denderden5621/PocketPal/images/05_baski_yonleri.png

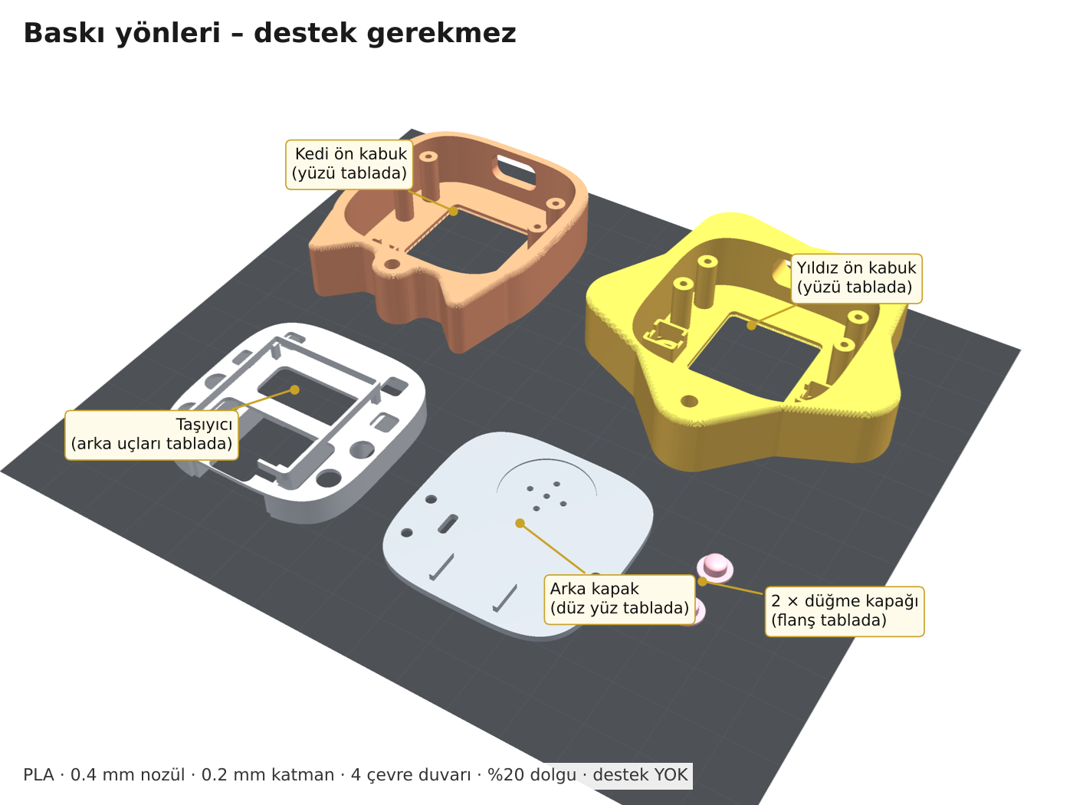
images/05_baski_yonleri.png
