denderden5621/PocketPal/images/06_kontroller.png

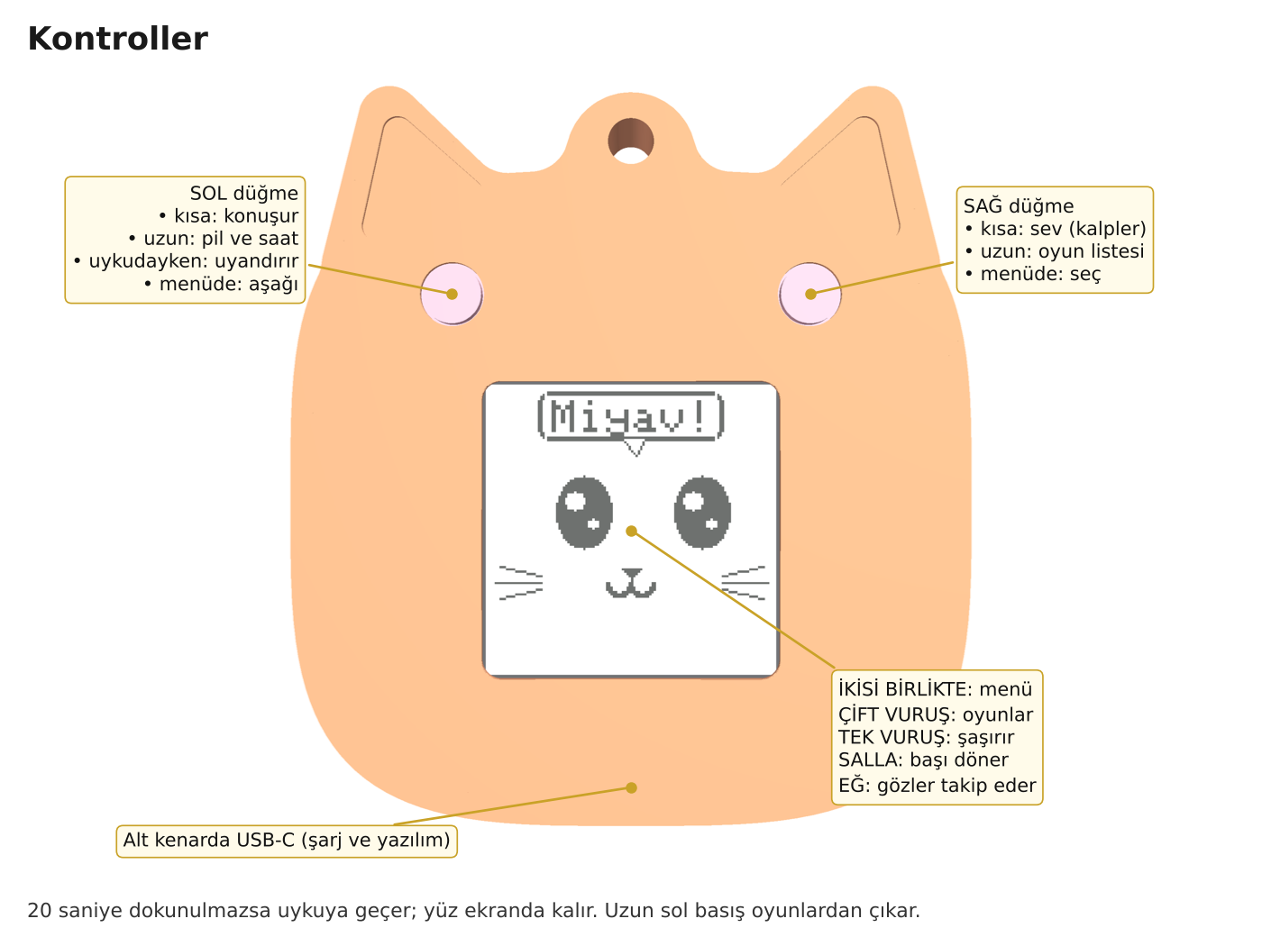
images/06_kontroller.png
