denderden5621/PocketPal/images/21_fpc_adaptor.png

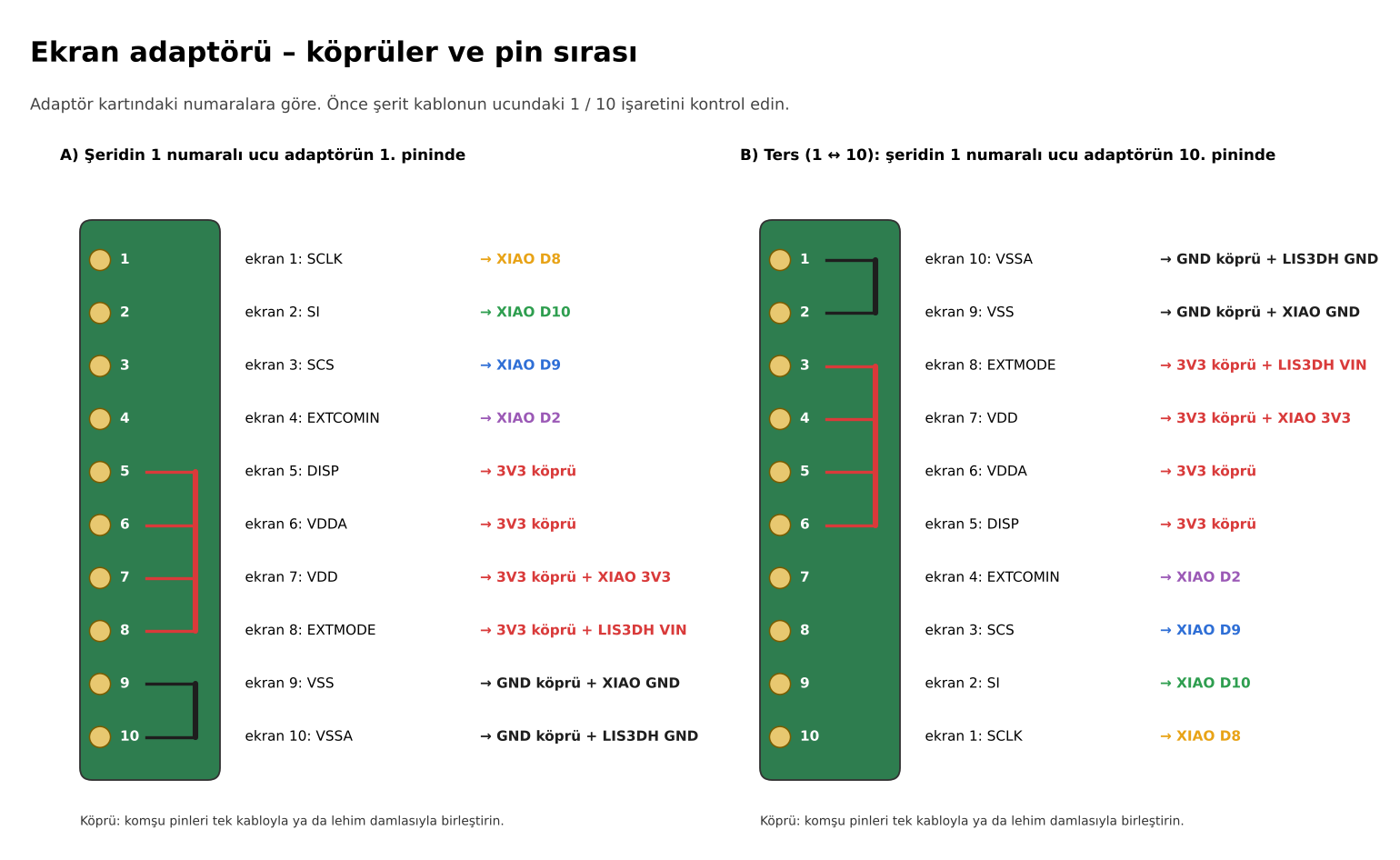
images/21_fpc_adaptor.png
