denderden5621/PocketPal/images/22_lis3dh_diyot.png

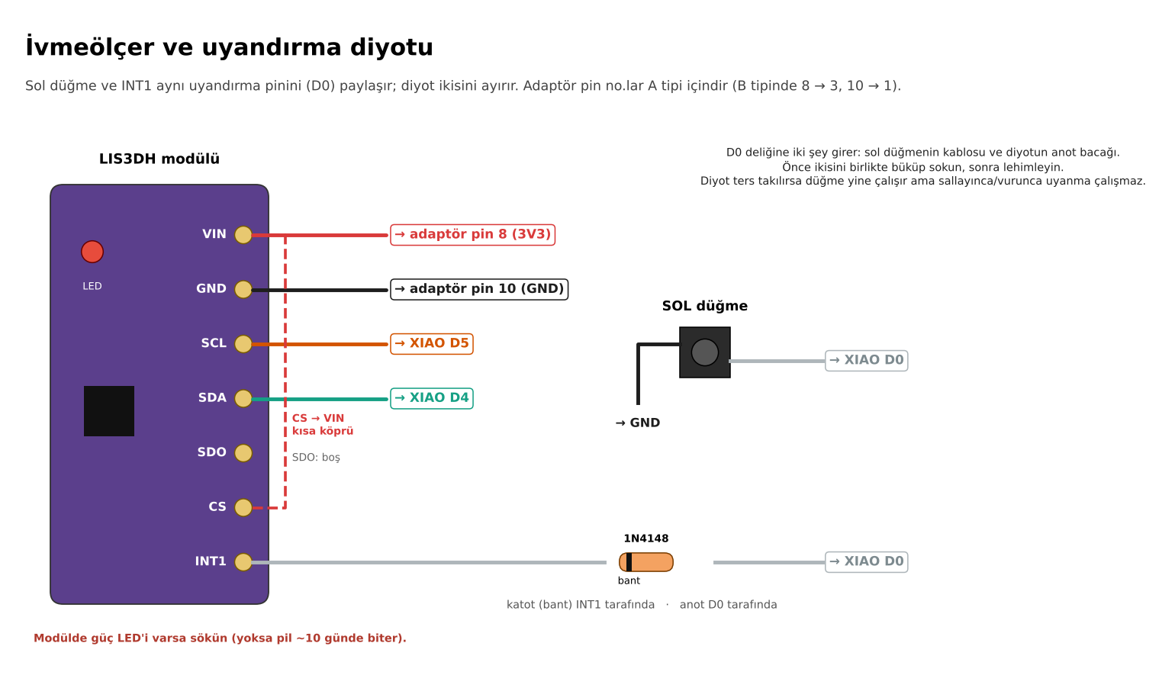
images/22_lis3dh_diyot.png
