denderden5621/PocketPal/images/23_guc_bolucu.png

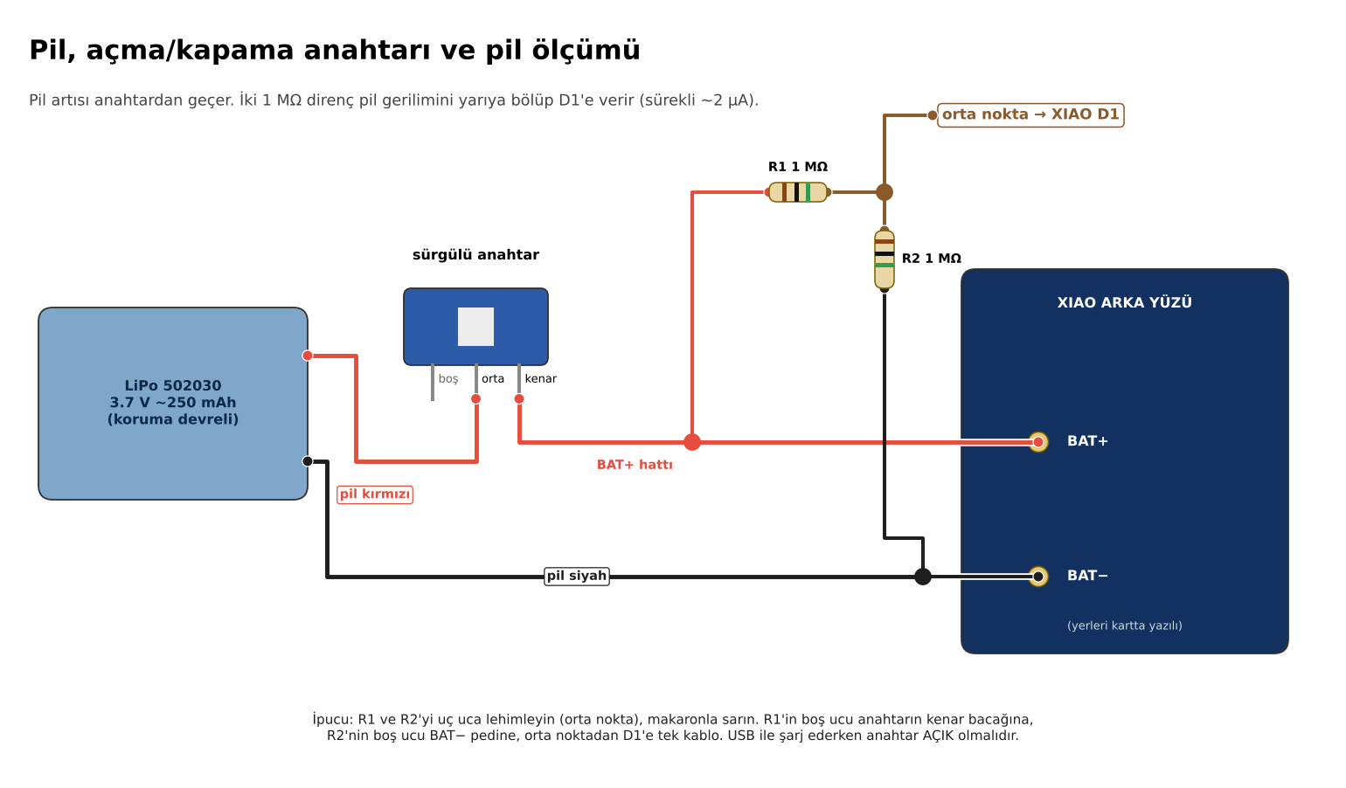
images/23_guc_bolucu.png
