denderden5621/PocketPal/images/screens/oyun_zipla_yildiz.png

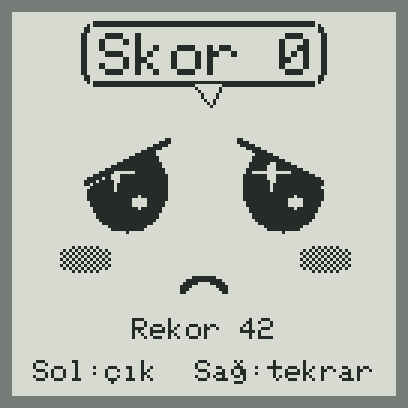
images/screens/oyun_zipla_yildiz.png
