denderden5621/PocketPal/images/screens/yildiz_bubble.png

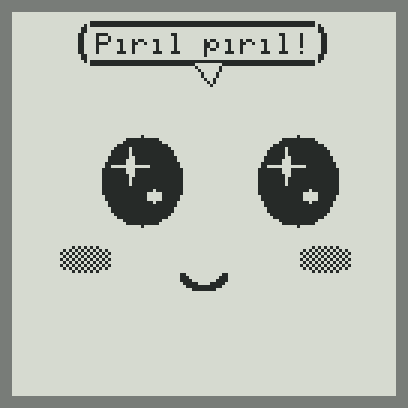
images/screens/yildiz_bubble.png
