denderden5621/PocketPal/images/screens/yildiz_sleepy.png

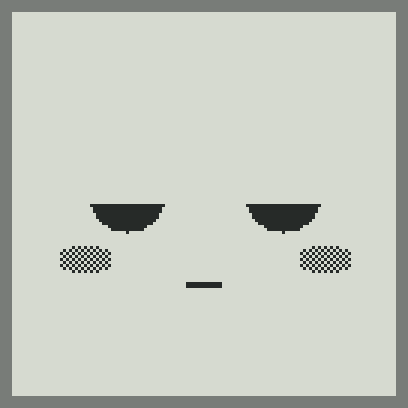
images/screens/yildiz_sleepy.png
