denderden5621/PocketPal/stl/kedi_on_kabuk.stl

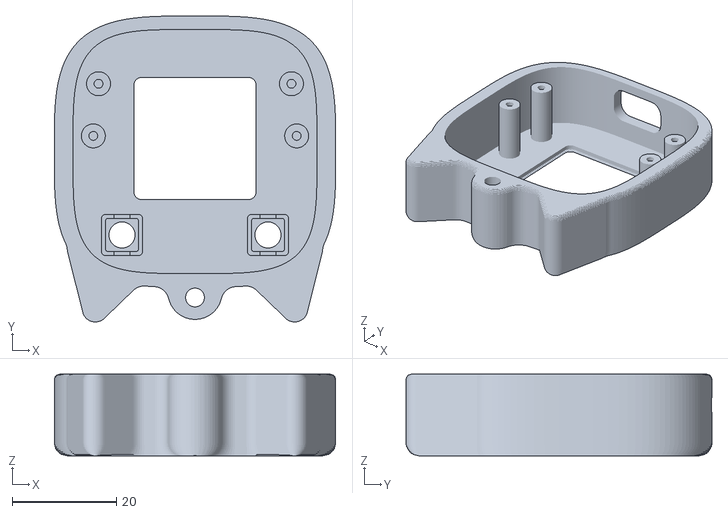
[picture p47: CAD file, 2026-10-17]
stl/kedi_on_kabuk.stl
54.0 x 58.7 x 15.6
