denderden5621/PocketPal/stl/dugme_kapagi.stl

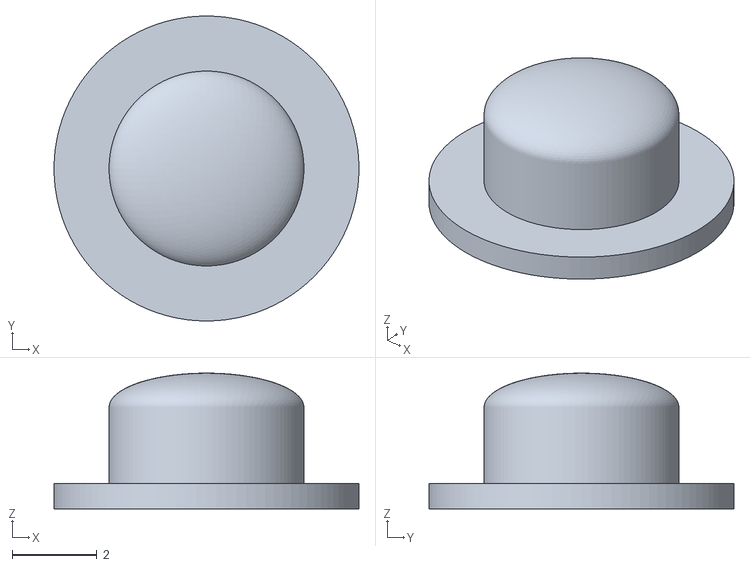
[picture p48: CAD file, 2026-10-17]
stl/dugme_kapagi.stl
7.20 x 7.20 x 3.20
