denderden5621/PocketPal/stl/arka_kapak.stl

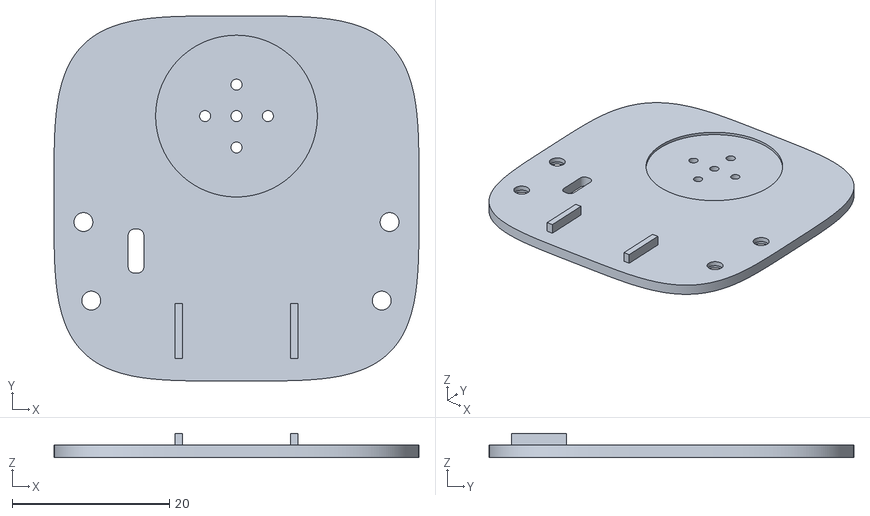
[picture p49: CAD file, 2026-10-17]
stl/arka_kapak.stl
46.5 x 46.5 x 3.10
