denderden5621/PocketPal/stl/yildiz_on_kabuk.stl

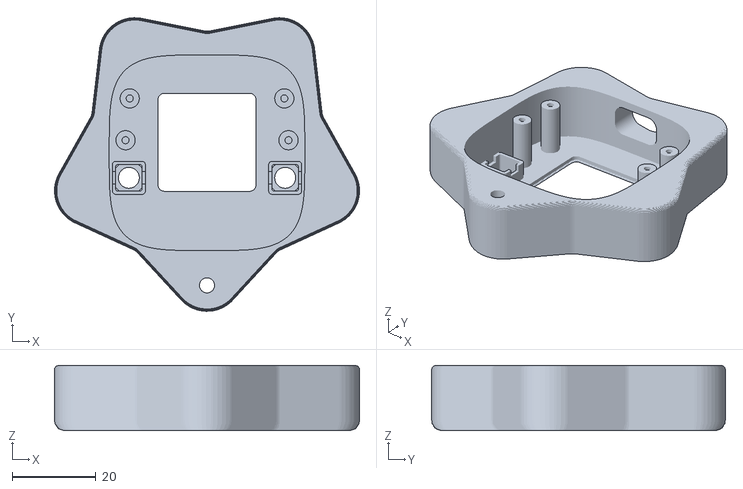
[picture p50: CAD file, 2026-10-17]
stl/yildiz_on_kabuk.stl
73.0 x 70.3 x 15.6
