denderden5621/PocketPal/stl/tasiyici.stl

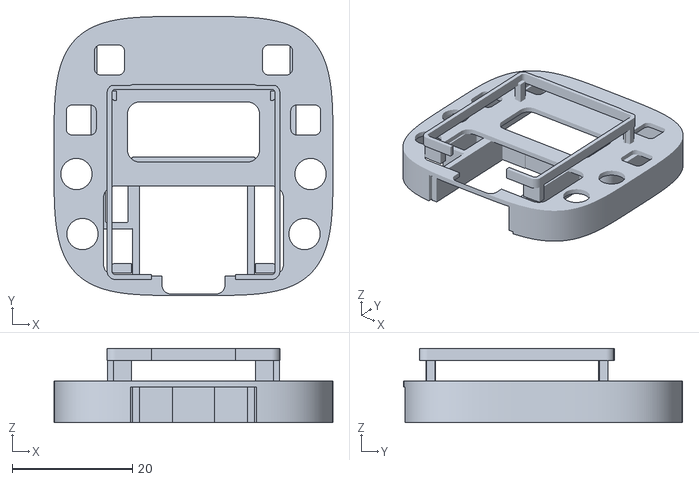
[picture p51: CAD file, 2026-10-17]
stl/tasiyici.stl
46.5 x 46.5 x 12.4
