denderden5621/PocketPal/images/10_montaj_on_katman.png

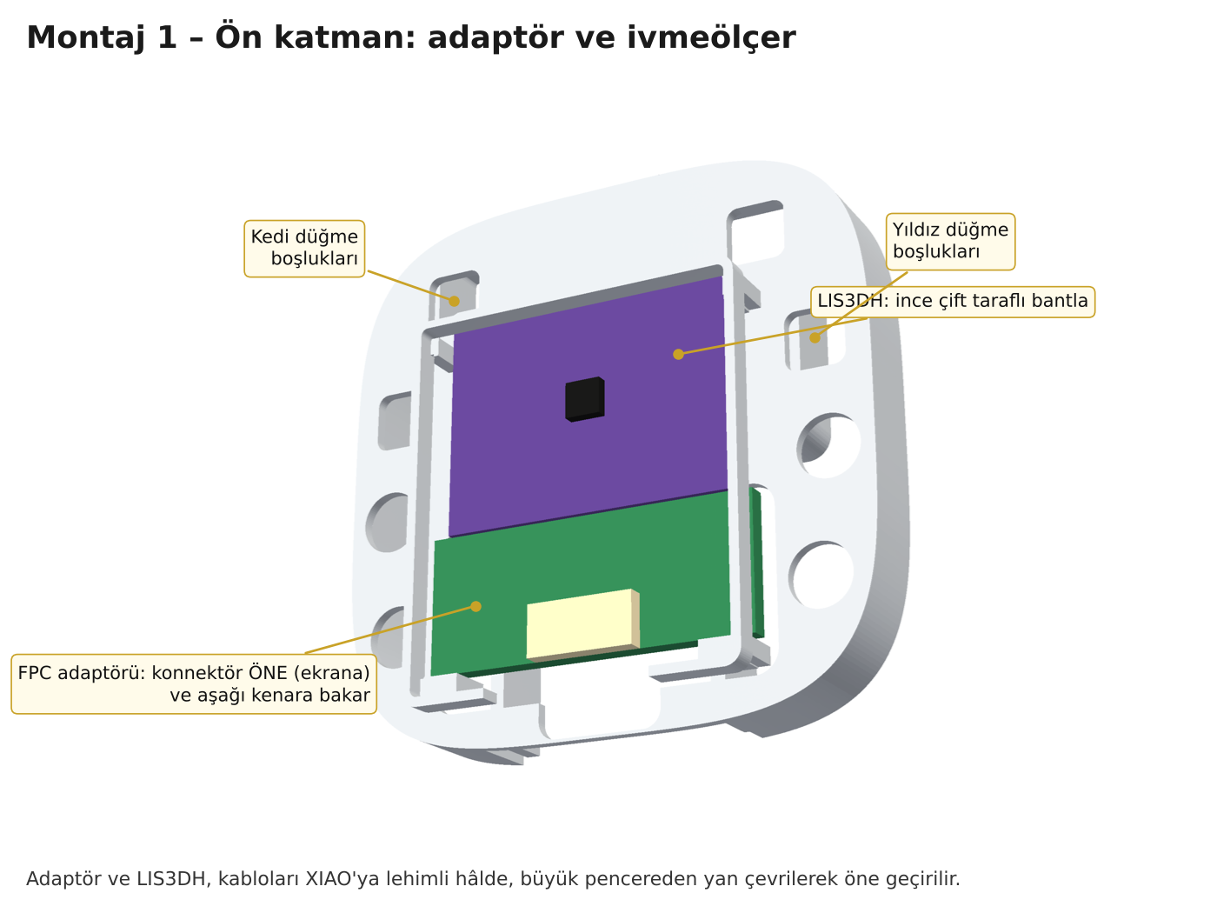
images/10_montaj_on_katman.png
