denderden5621/PocketPal/images/11_montaj_ekran.png

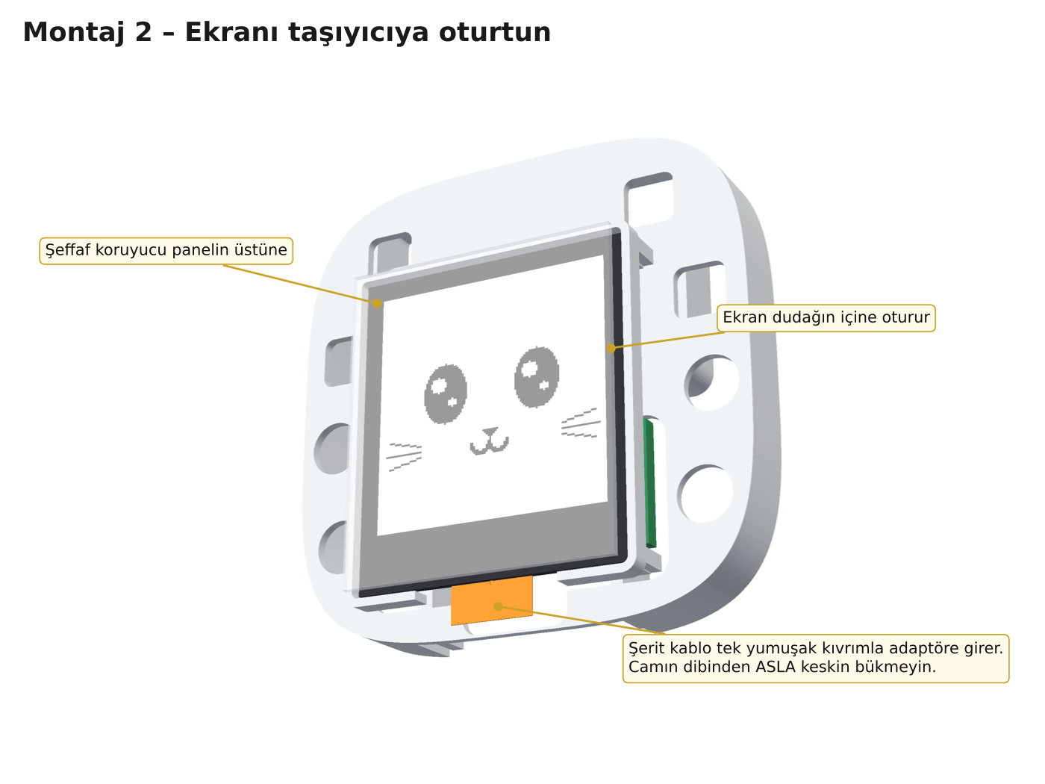
images/11_montaj_ekran.png
