denderden5621/PocketPal/images/12_montaj_arka_katman.png

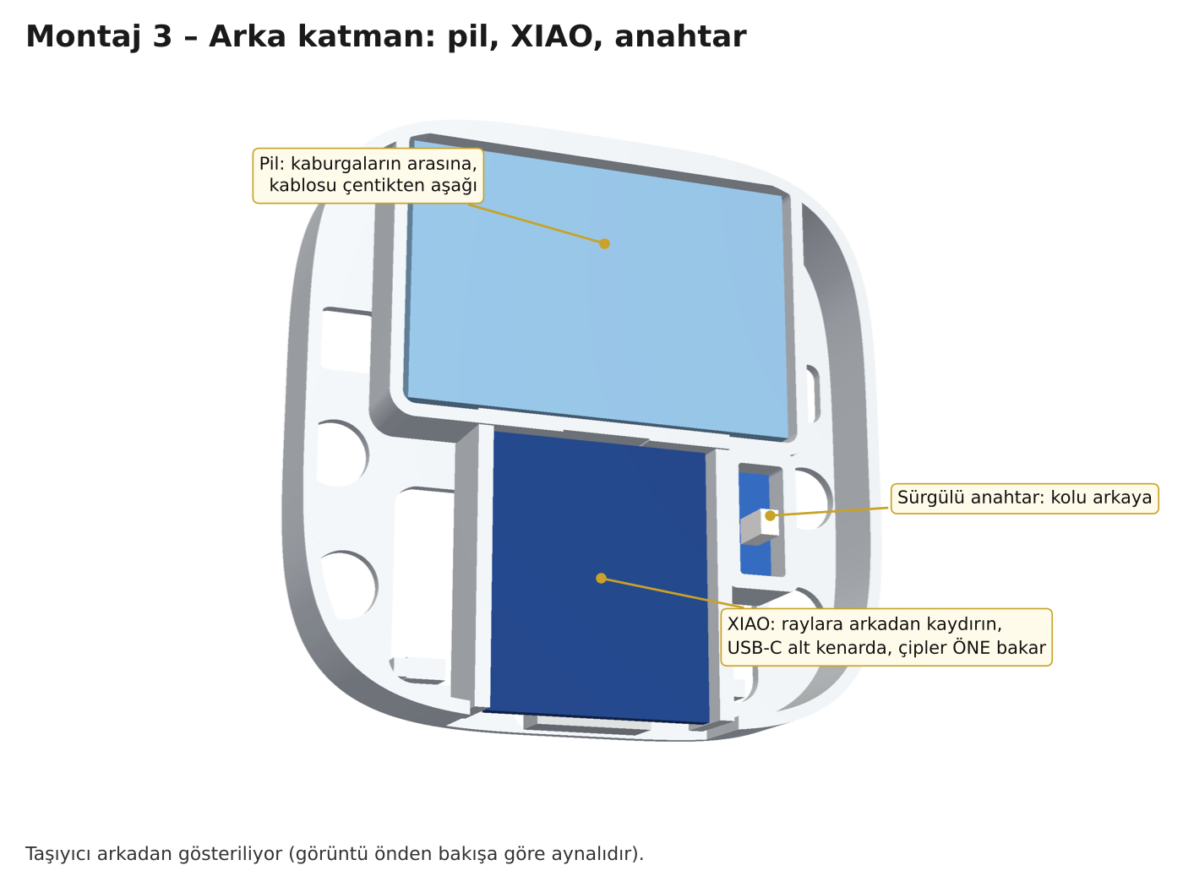
images/12_montaj_arka_katman.png
