denderden5621/PocketPal/images/13_montaj_piezo.png

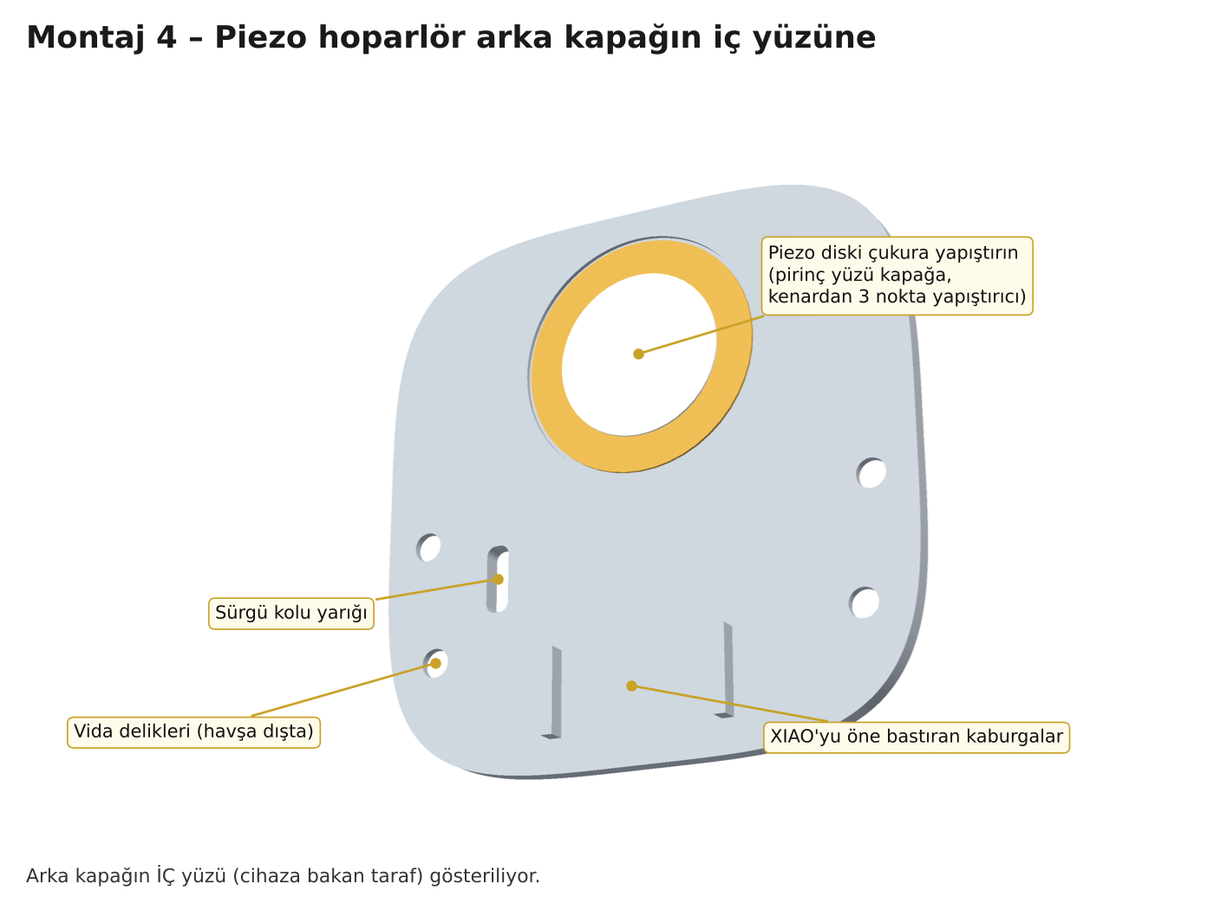
images/13_montaj_piezo.png
