denderden5621/PocketPal/images/14_montaj_dugmeler_kedi.png

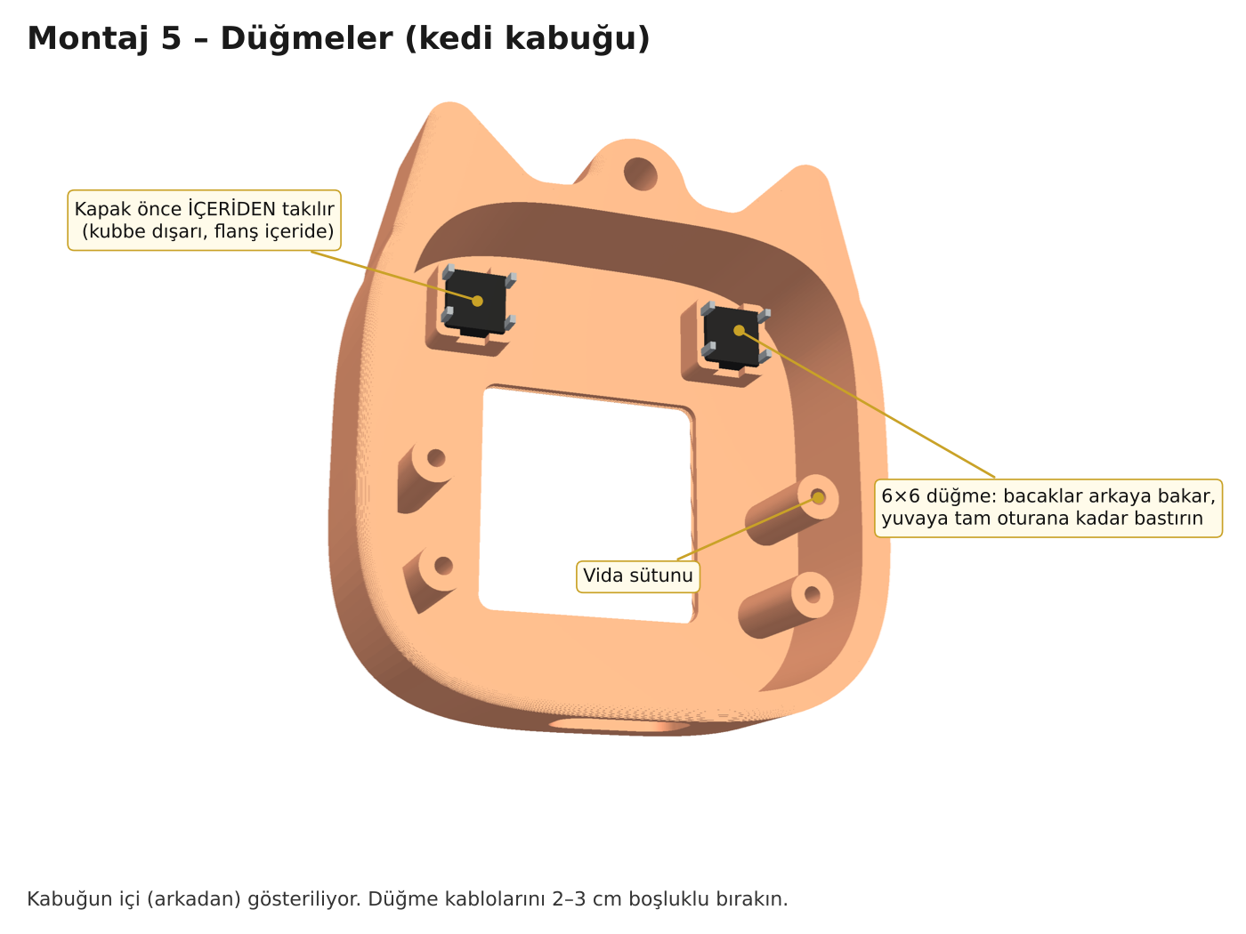
images/14_montaj_dugmeler_kedi.png
