denderden5621/PocketPal/images/15_montaj_dugmeler_yildiz.png

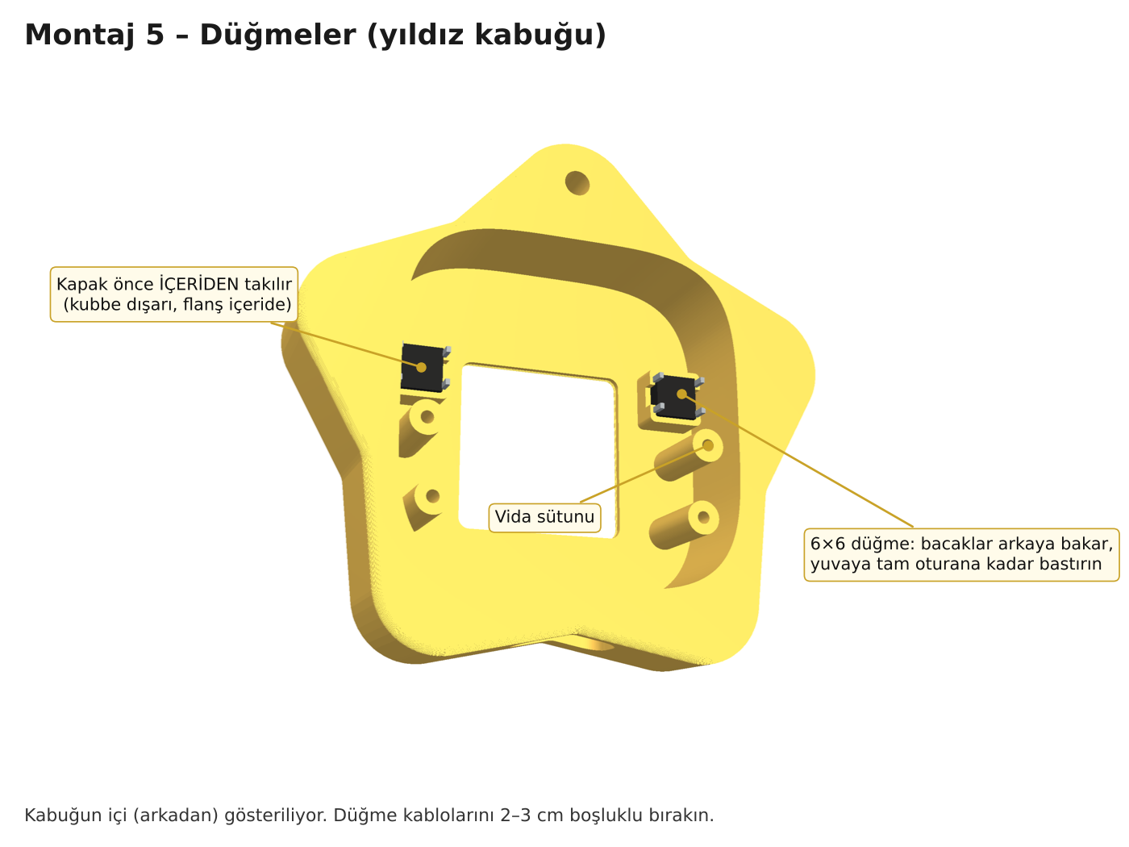
images/15_montaj_dugmeler_yildiz.png
