denderden5621/PocketPal/images/16_montaj_kabuga.png

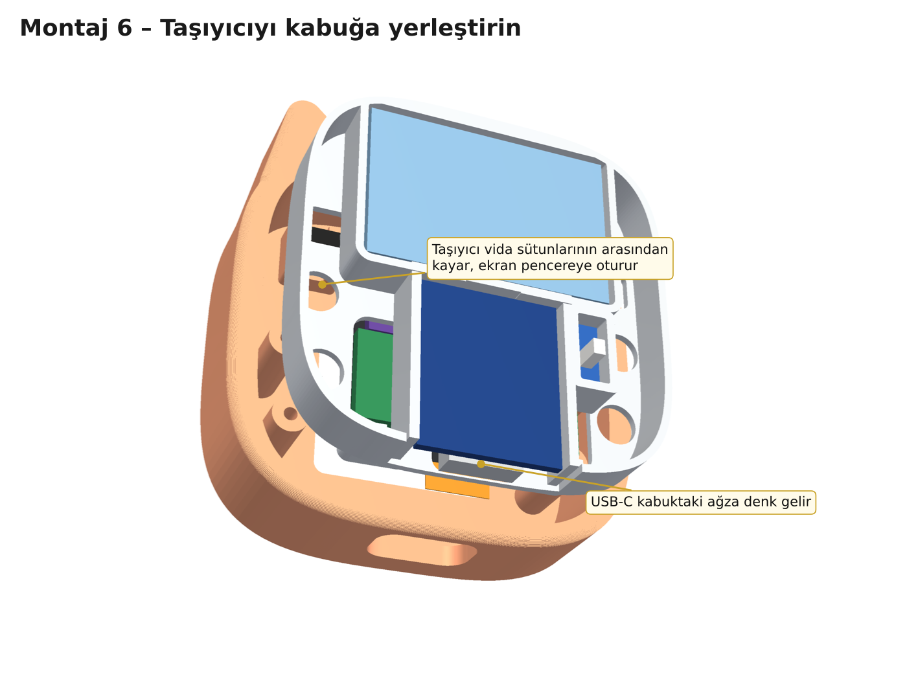
images/16_montaj_kabuga.png
