denderden5621/PocketPal/images/17_montaj_kapatma.png

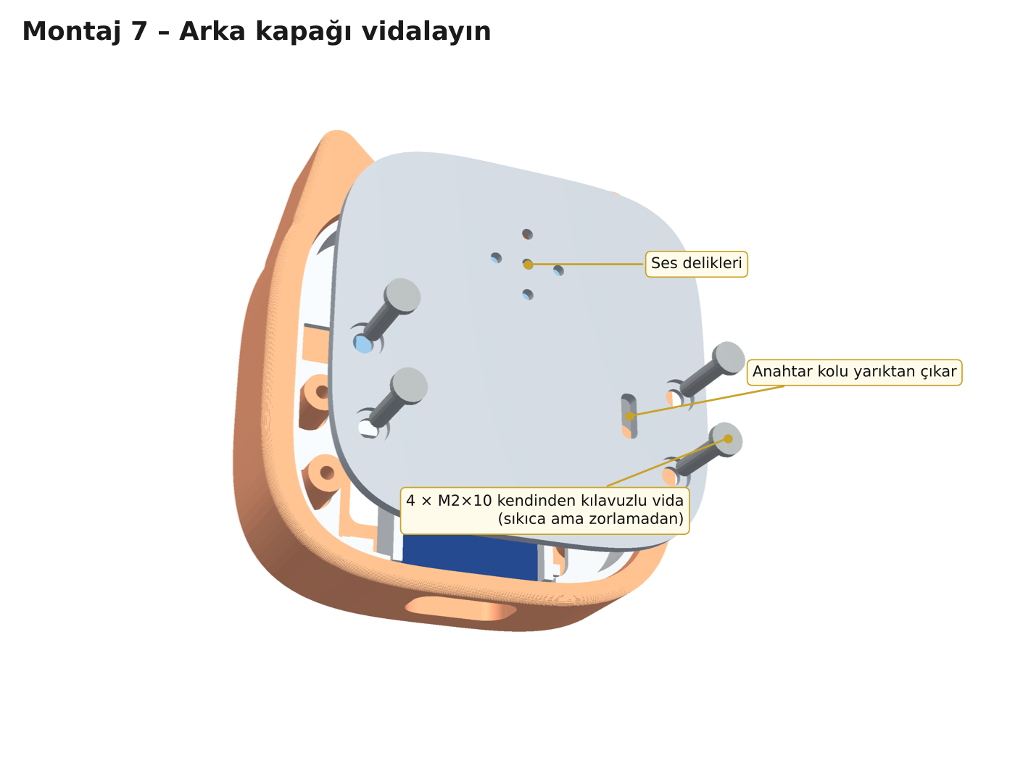
images/17_montaj_kapatma.png
